lolobernardi/eeg-headset-project/README.md

# eeg-headset-project
Proyecto para el desarrollo de un casco EEG inalámbrico y portátil
