lolobernardi/eeg-headset-project/hardware/Casco_EEG_Kicad/3D_models/USB4125-GF-A_REVA2.step

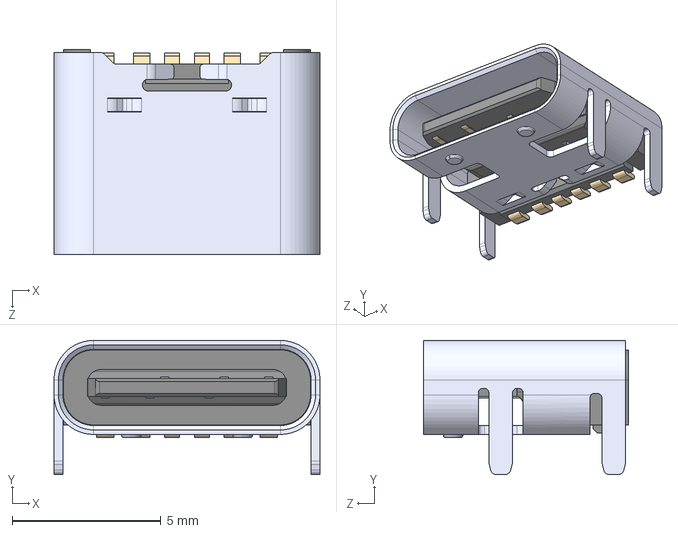
[picture p1: CAD file, 2025-10-28]
hardware/Casco_EEG_Kicad/3D_models/USB4125-GF-A_REVA2.step
8.94 x 4.51 x 6.90 mm
