lolobernardi/eeg-headset-project/hardware/Casco_EEG_Kicad/3D_models/PCM12SMTR.step

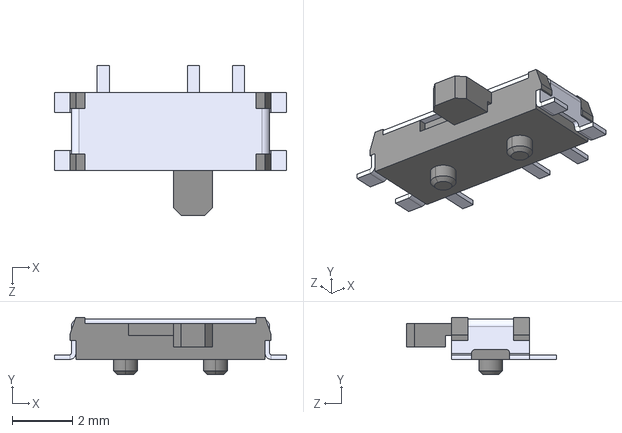
[picture p2: CAD file, 2025-10-28]
hardware/Casco_EEG_Kicad/3D_models/PCM12SMTR.step
7.72 x 1.91 x 4.98 mm
