lolobernardi/eeg-headset-project/hardware/Casco_EEG_Kicad/3D_models/AP2112K-3.3TRG1.step

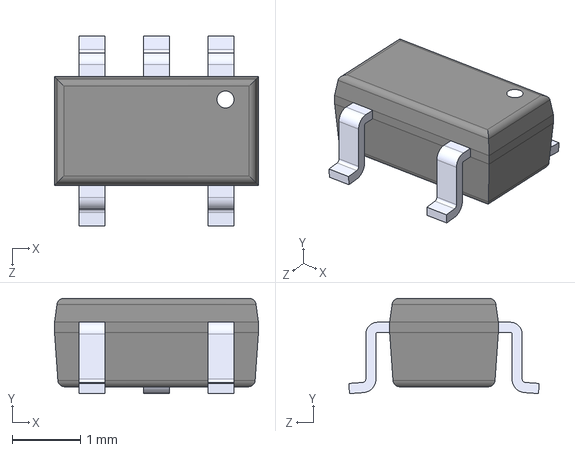
[picture p3: CAD file, 2025-10-09]
hardware/Casco_EEG_Kicad/3D_models/AP2112K-3.3TRG1.step
3.00 x 1.40 x 2.80 mm
