lolobernardi/eeg-headset-project/hardware/Casco_EEG_Kicad/3D_models/ADS1299IPAGR.STEP

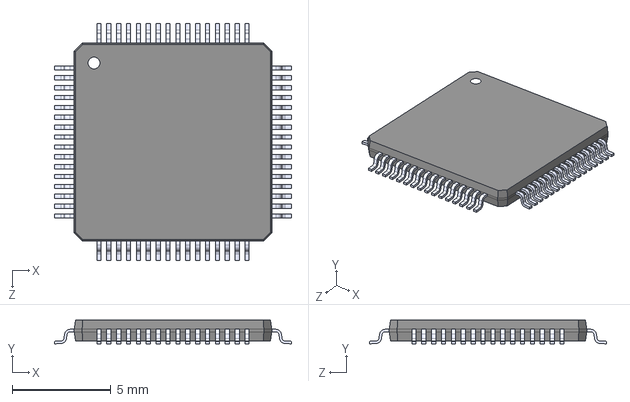
[picture p4: CAD file, 2025-10-09]
hardware/Casco_EEG_Kicad/3D_models/ADS1299IPAGR.STEP
12.0 x 1.20 x 12.0 mm
