lolobernardi/eeg-headset-project/hardware/Casco_EEG_Kicad/3D_models/TL3305AF160QG--3DModel-STEP-520916.STEP

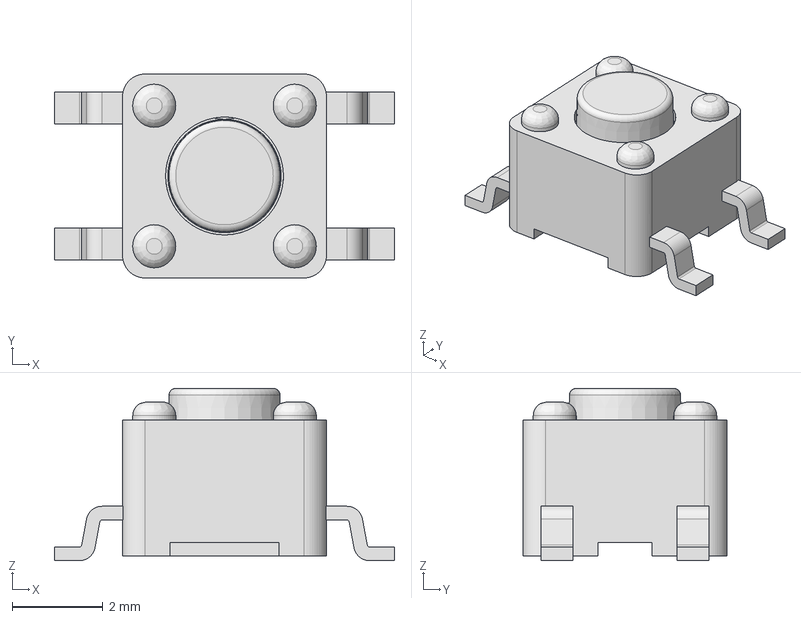
[picture p5: CAD file, 2025-10-09]
hardware/Casco_EEG_Kicad/3D_models/TL3305AF160QG--3DModel-STEP-520916.STEP
7.50 x 4.50 x 3.80 mm
