lolobernardi/eeg-headset-project/hardware/Casco_EEG_Kicad/3D_models/HZ0805E601R-10--3DModel-STEP-510211.STEP

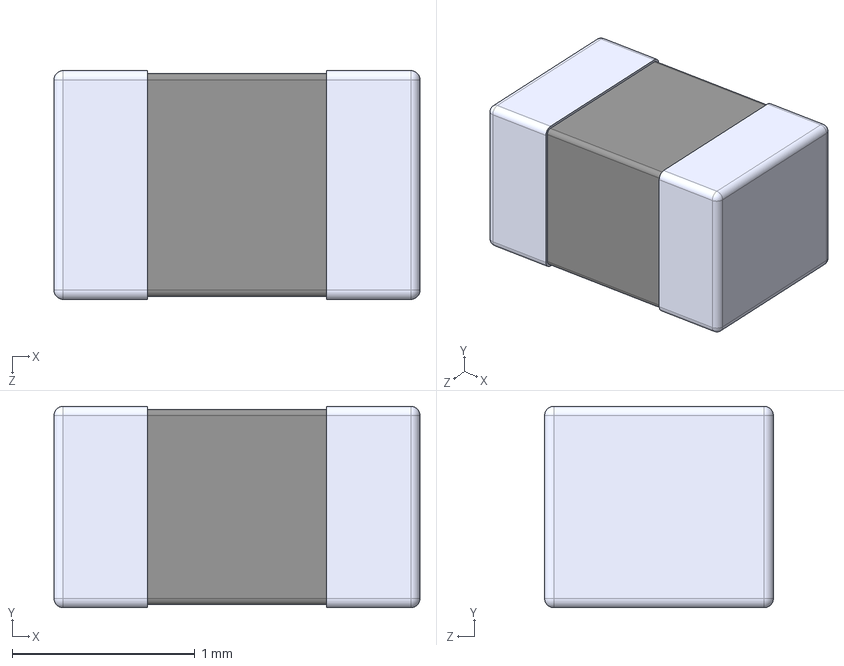
[picture p6: CAD file, 2025-10-09]
hardware/Casco_EEG_Kicad/3D_models/HZ0805E601R-10--3DModel-STEP-510211.STEP
2.00 x 1.10 x 1.25 mm
