lolobernardi/eeg-headset-project/hardware/Casco_EEG_Kicad/3D_models/USB3080-XX-00-A_REVE.step

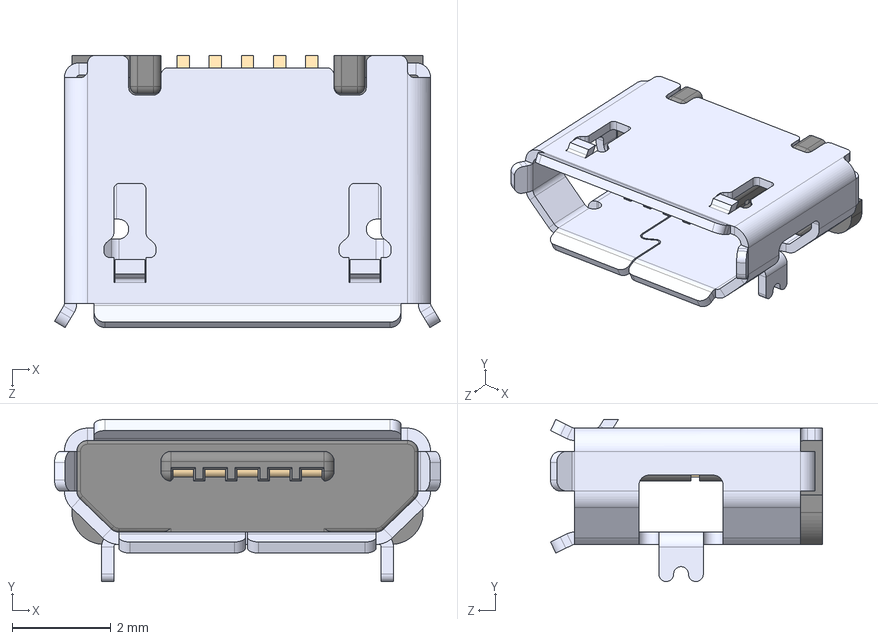
[picture p7: CAD file, 2025-10-09]
hardware/Casco_EEG_Kicad/3D_models/USB3080-XX-00-A_REVE.step
7.80 x 3.28 x 5.50 mm
