lolobernardi/eeg-headset-project/hardware/Casco_EEG_Kicad/3D_models/TP4056--3DModel-STEP-56544.STEP

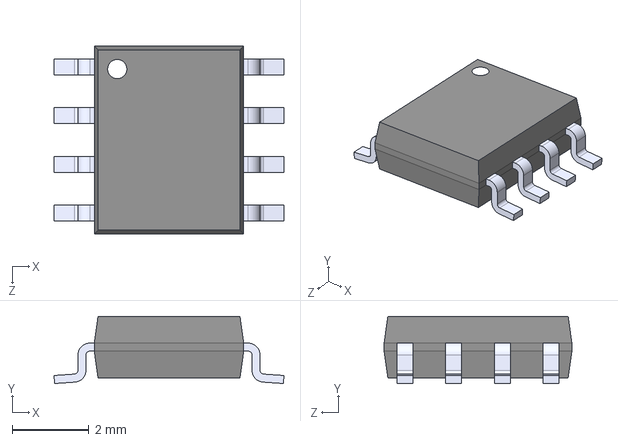
[picture p8: CAD file, 2025-10-09]
hardware/Casco_EEG_Kicad/3D_models/TP4056--3DModel-STEP-56544.STEP
6.00 x 1.75 x 4.90 mm
