lolobernardi/eeg-headset-project/hardware/Casco_EEG_Kicad/3D_models/SKRPABE010.step

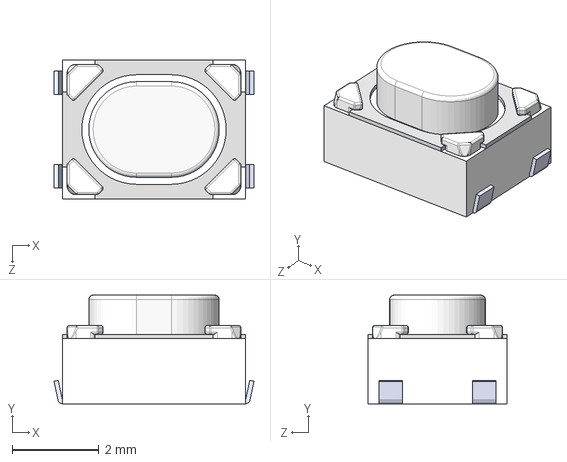
[picture p9: CAD file, 2025-10-02]
hardware/Casco_EEG_Kicad/3D_models/SKRPABE010.step
4.60 x 2.50 x 3.20 mm
