lolobernardi/eeg-headset-project/hardware/Casco_EEG_Kicad/3D_models/ME2108A33P.step

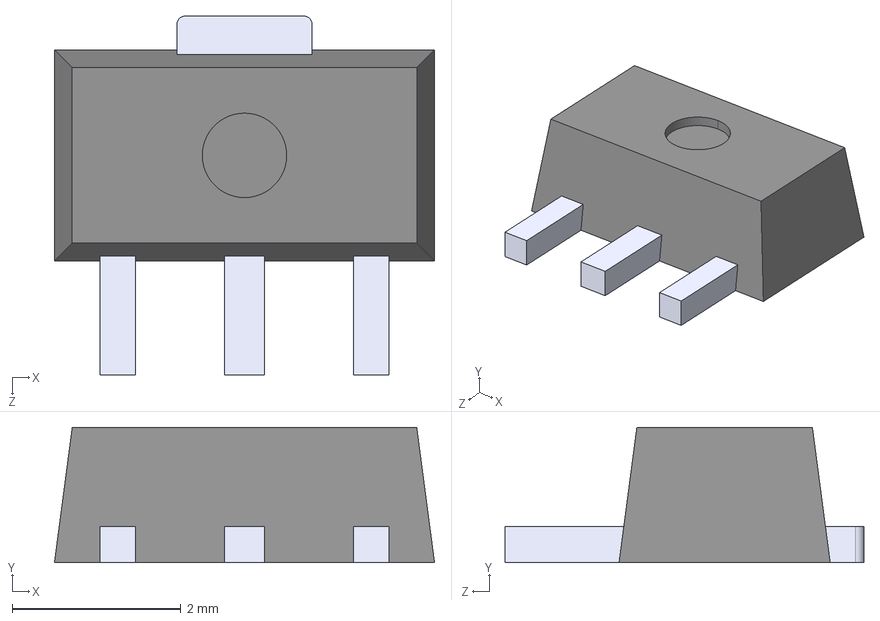
[picture p10: CAD file, 2025-10-02]
hardware/Casco_EEG_Kicad/3D_models/ME2108A33P.step
4.50 x 1.60 x 4.25 mm
