lolobernardi/eeg-headset-project/hardware/Casco_EEG_Kicad/3D_models/LPC845M301JBD64E.STEP

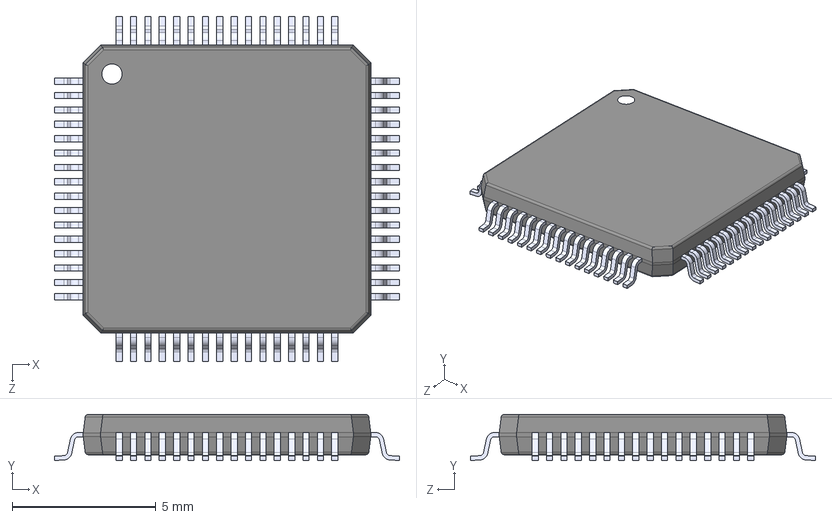
[picture p11: CAD file, 2025-10-02]
hardware/Casco_EEG_Kicad/3D_models/LPC845M301JBD64E.STEP
12.0 x 1.60 x 12.0 mm
