lolobernardi/eeg-headset-project/hardware/Casco_EEG_Kicad/3D_models/FS8205A.step

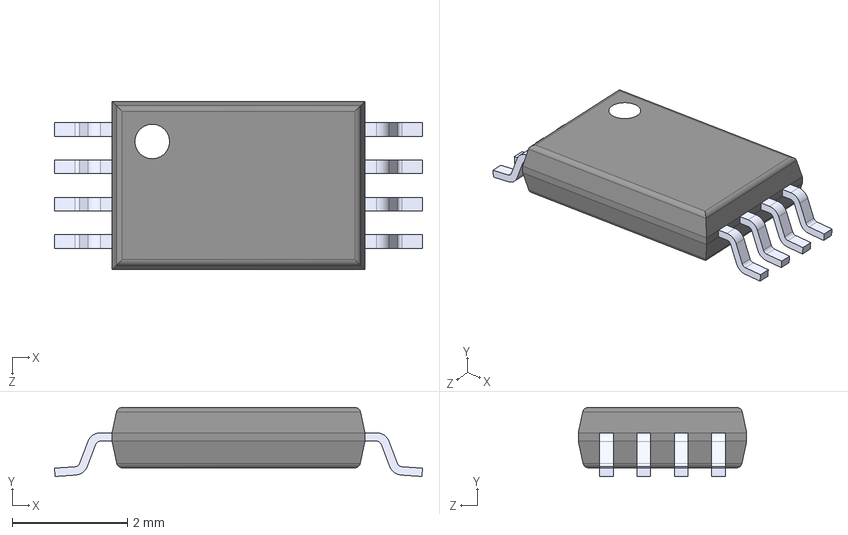
[picture p12: CAD file, 2025-10-02]
hardware/Casco_EEG_Kicad/3D_models/FS8205A.step
6.40 x 1.20 x 2.93 mm
