lolobernardi/eeg-headset-project/hardware/Casco_EEG_Kicad/3D_models/HC-05--3DModel-STEP-56544.STEP

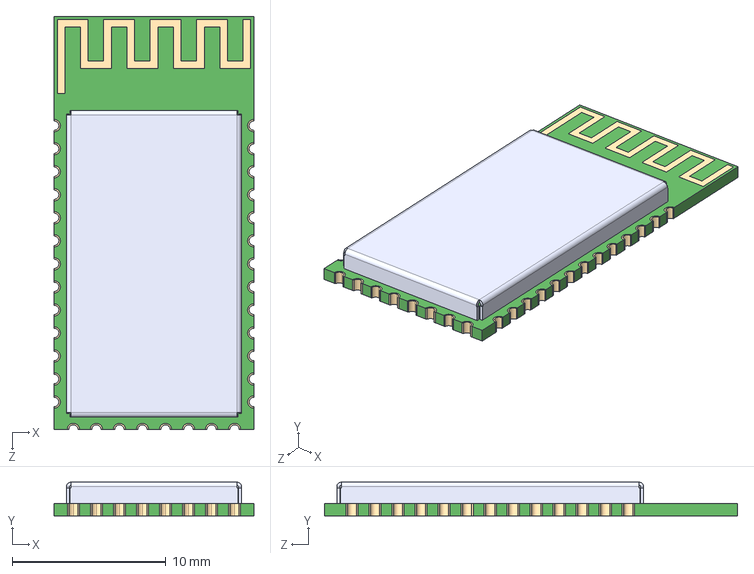
[picture p13: CAD file, 2025-10-02]
hardware/Casco_EEG_Kicad/3D_models/HC-05--3DModel-STEP-56544.STEP
13.0 x 2.20 x 26.9 mm
