lolobernardi/eeg-headset-project/hardware/Casco_EEG_Kicad/3D_models/FTSH-105-XX-X-DV.step

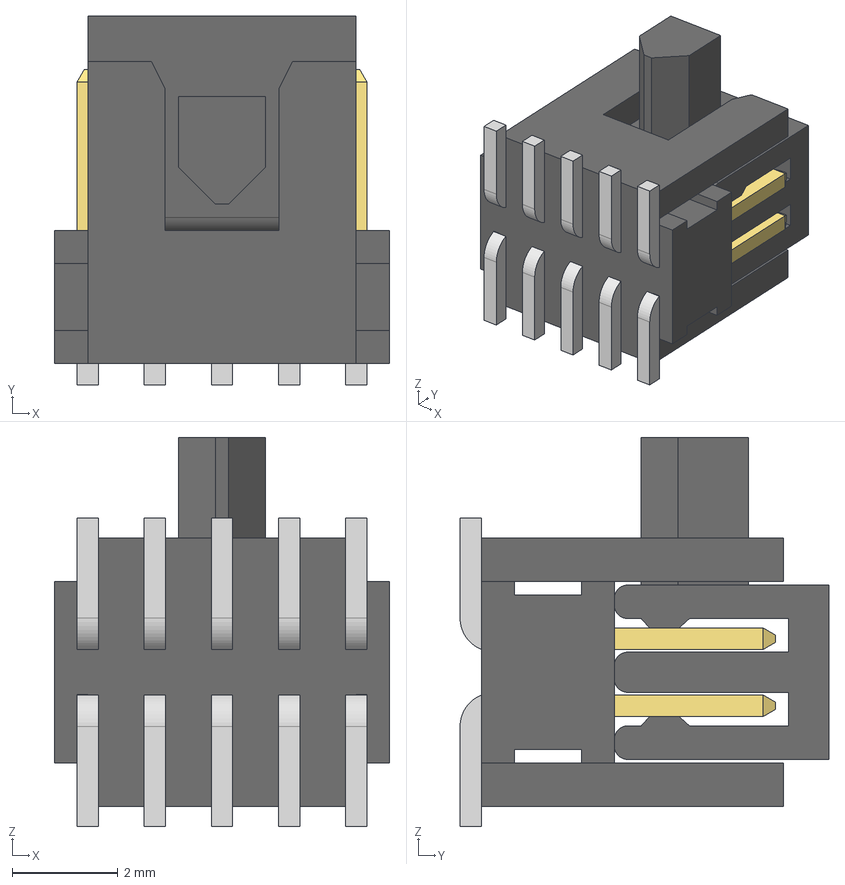
[picture p14: CAD file, 2025-10-02]
hardware/Casco_EEG_Kicad/3D_models/FTSH-105-XX-X-DV.step
6.35 x 6.98 x 7.37 mm
FTSH-105-01-L-DV-K-P_body
FTSH-105-01-L-DV-K-P_pins1
FTSH-105-01-L-DV-K-P_pins2
FTSH-105-01-L-DV-K-P_pp_pad
