lolobernardi/eeg-headset-project/hardware/Casco_EEG_Kicad/3D_models/Jack_TouchProof_1.5mm.STEP

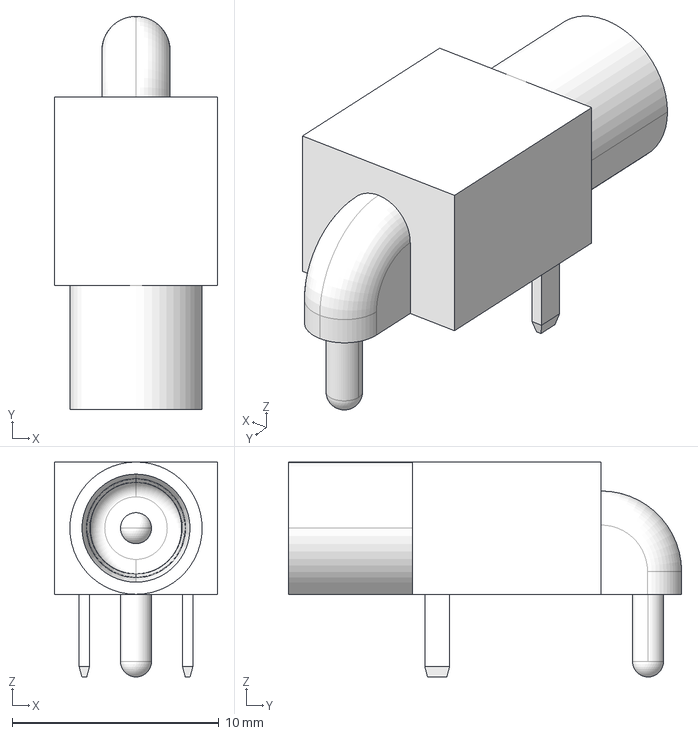
[picture p15: CAD file, 2025-10-02]
hardware/Casco_EEG_Kicad/3D_models/Jack_TouchProof_1.5mm.STEP
7.90 x 19.0 x 10.4 mm
