lolobernardi/eeg-headset-project/hardware/Casco_EEG_Kicad/3D_models/QFP50P900X900X160-48N.step

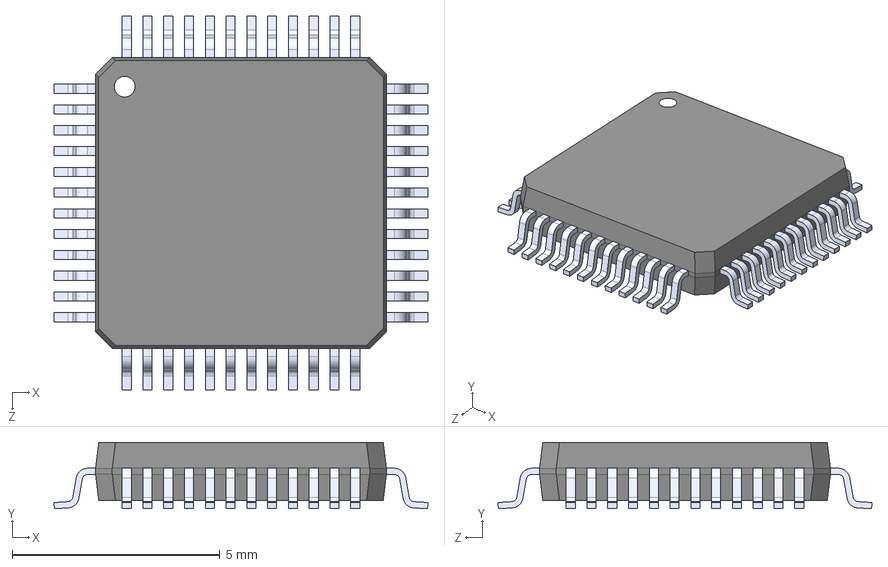
[picture p16: CAD file, 2025-09-03]
hardware/Casco_EEG_Kicad/3D_models/QFP50P900X900X160-48N.step
9.00 x 1.60 x 9.00 mm
