lolobernardi/eeg-headset-project/hardware/Casco_EEG_Kicad/PDFs/Casco_EEG_Kicad.pdf

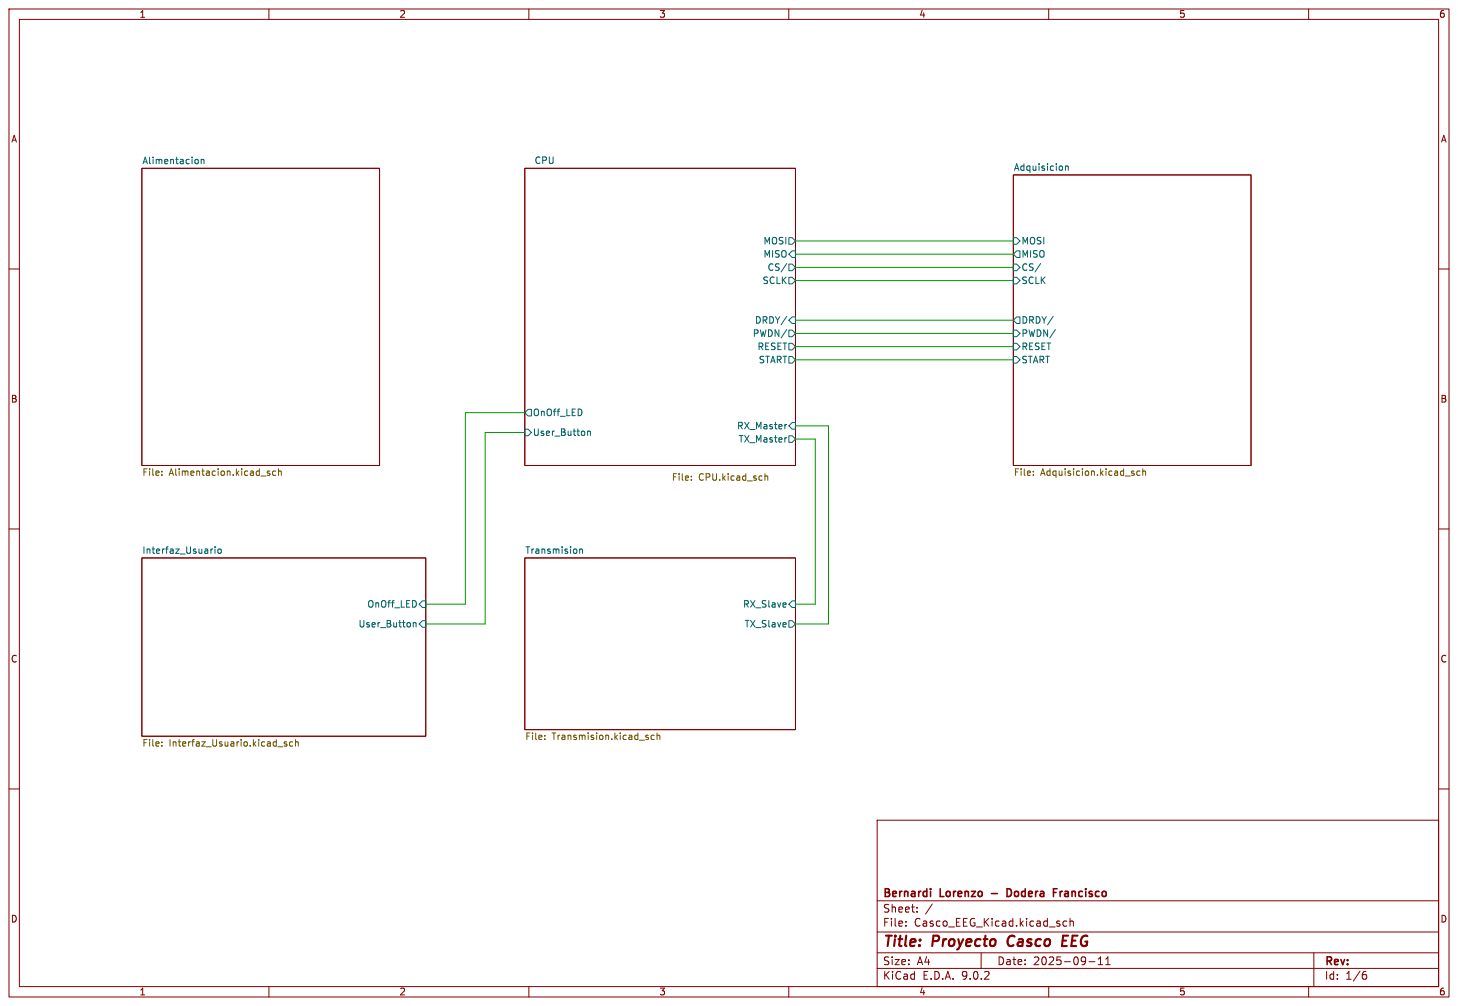
[picture p17: page 1]

START Adquisicion File: Adquisicion.kicad_sch RX_Master CS/ DRDY/ MISO MOSI PWDN/ RESET SCLK

CS/ DRDY/ MISO MOSI PWDN/ RESET SCLK

File: CPU.kicad_sch RX_Slave TX_Slave Transmision File: Transmision.kicad_sch

Id: 1/6 Title: Proyecto Casco EEG

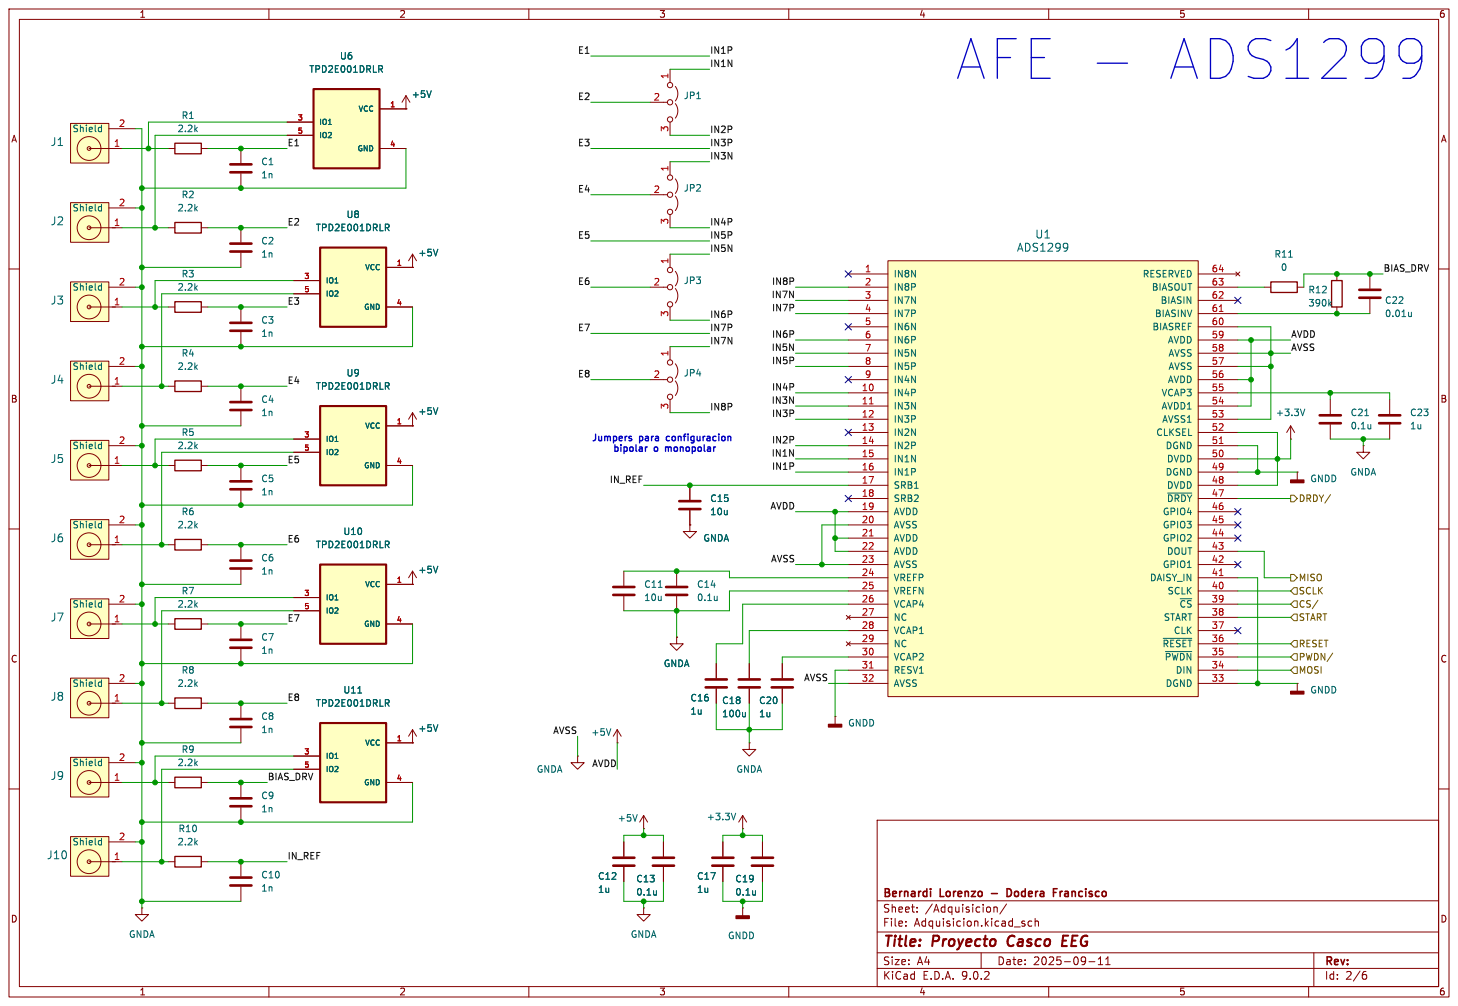
[picture p18: page 2]

START RESET MOSI PWDN/ DRDY/ SCLK MISO

Id: 2/6 Title: Proyecto Casco EEG

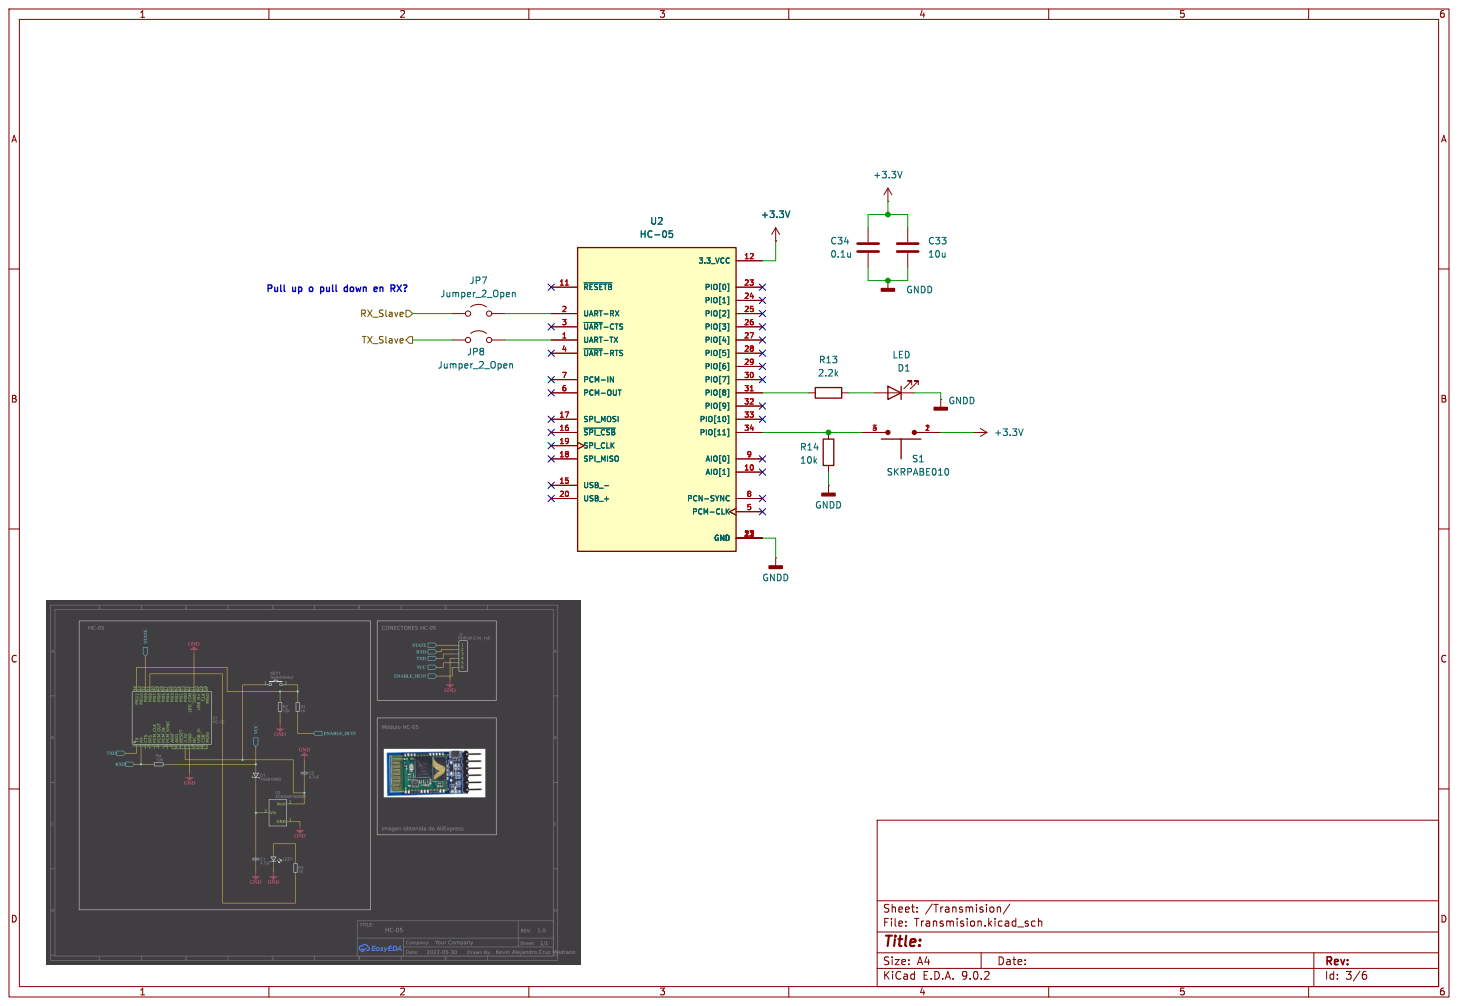
[picture p19: page 3]

TX_Slave RX_Slave Pull up o pull down en RX?

Id: 3/6 Title: File: Transmision.kicad_sch Sheet: /Transmision/

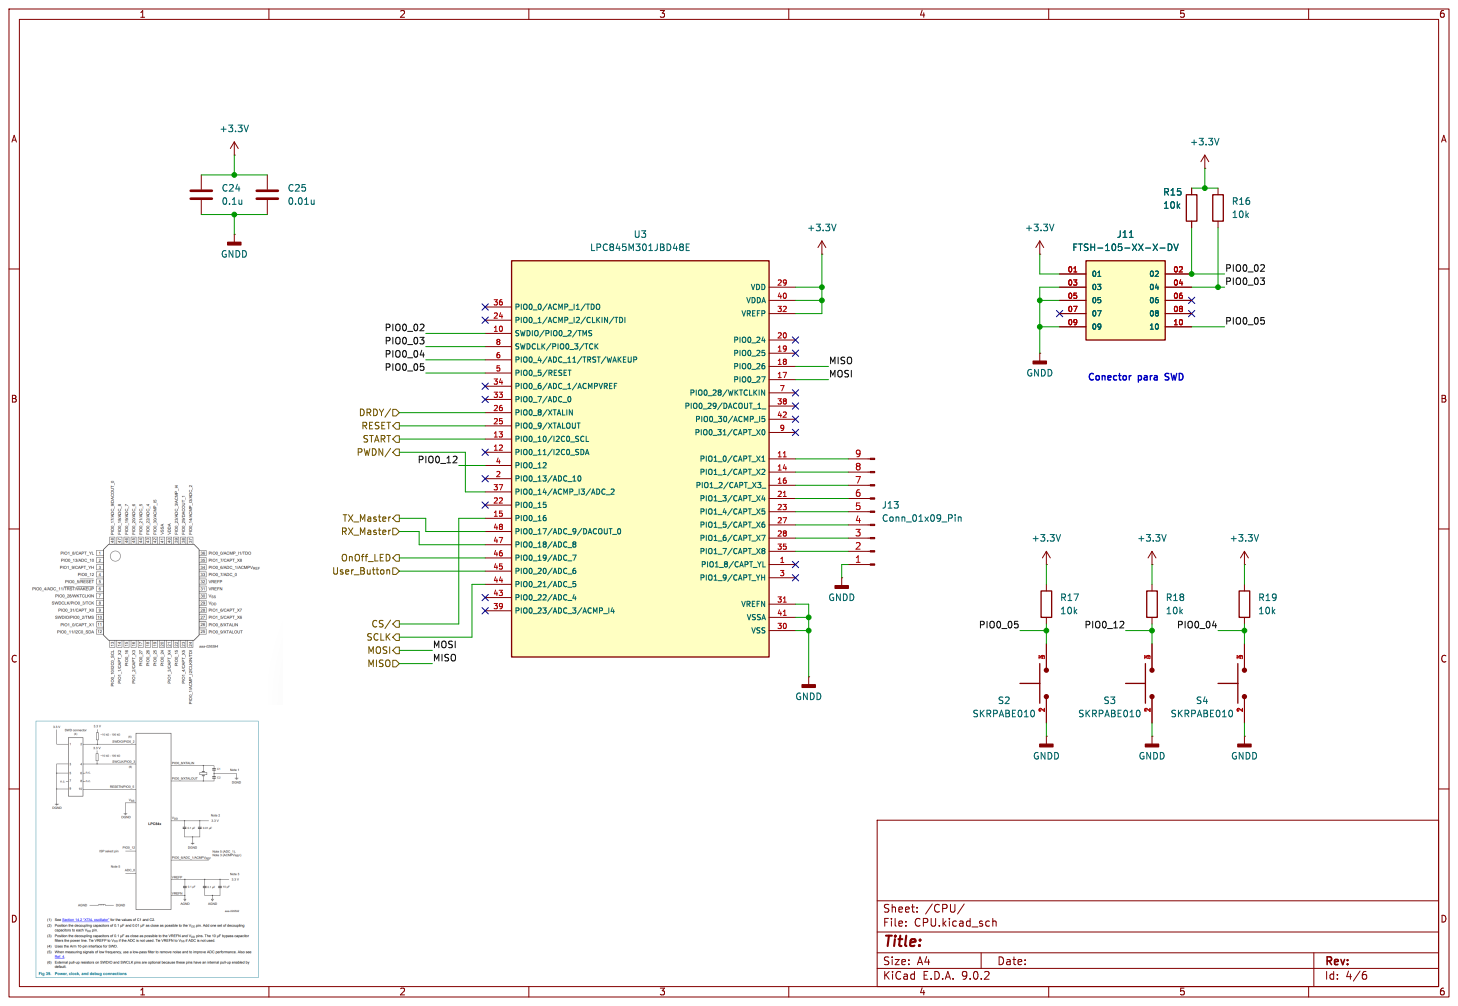
[picture p20: page 4]

RX_Master PWDN/ RESET START SCLK
CS/ TX_Master User_Button OnOff_LED

Id: 4/6 Title: File: CPU.kicad_sch Sheet: /CPU/

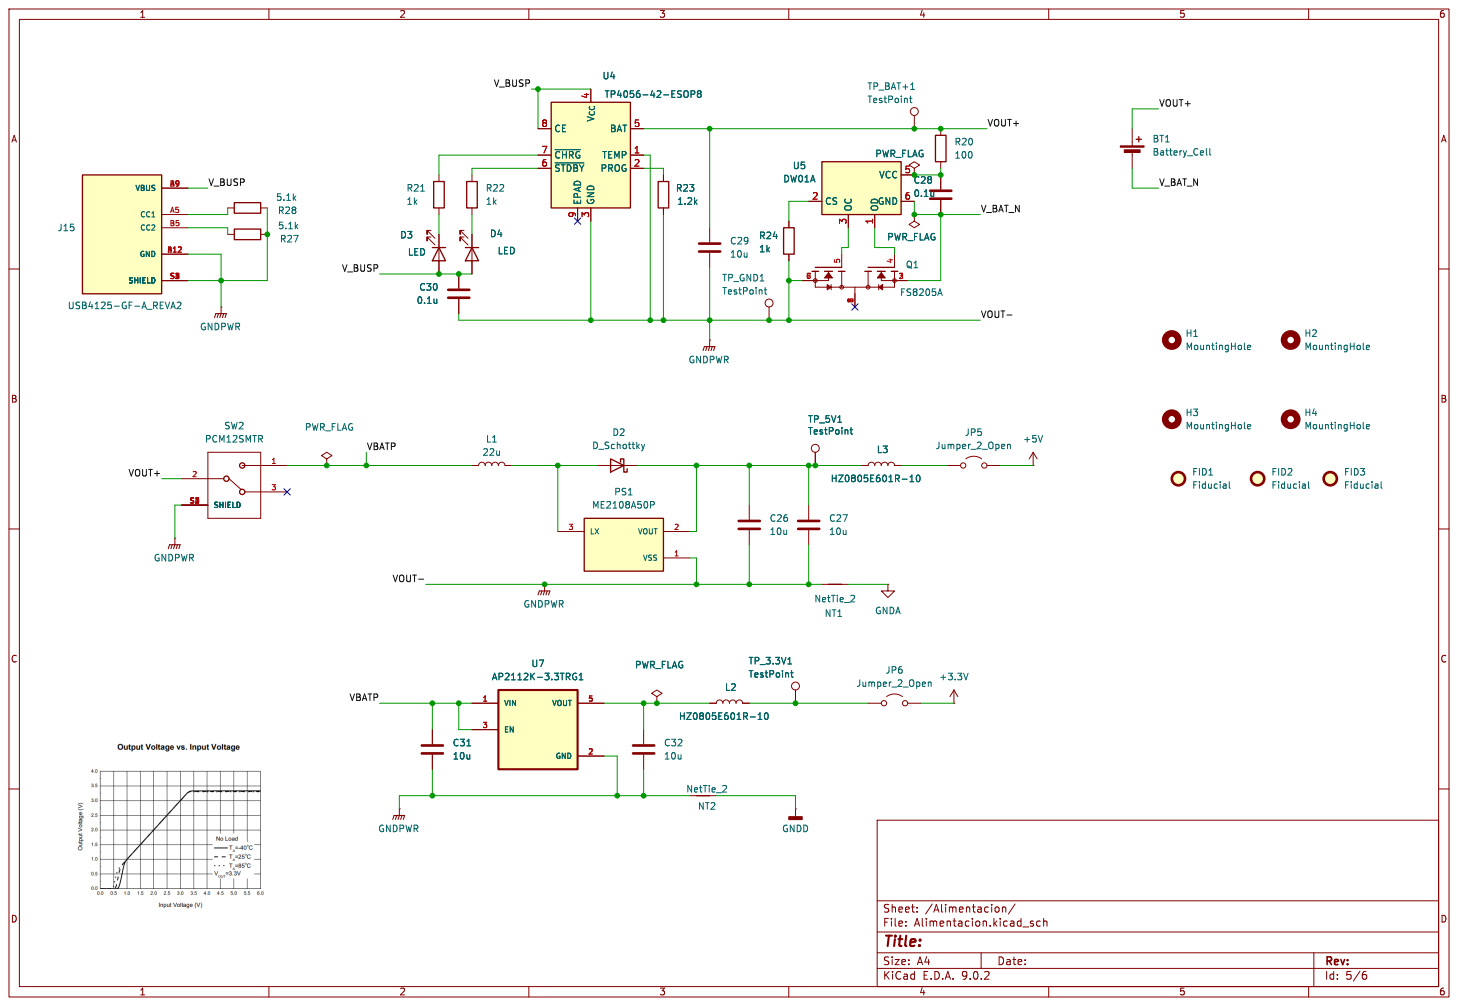
[picture p21: page 5]

Id: 5/6 Title: File: Alimentacion.kicad_sch Sheet: /Alimentacion/

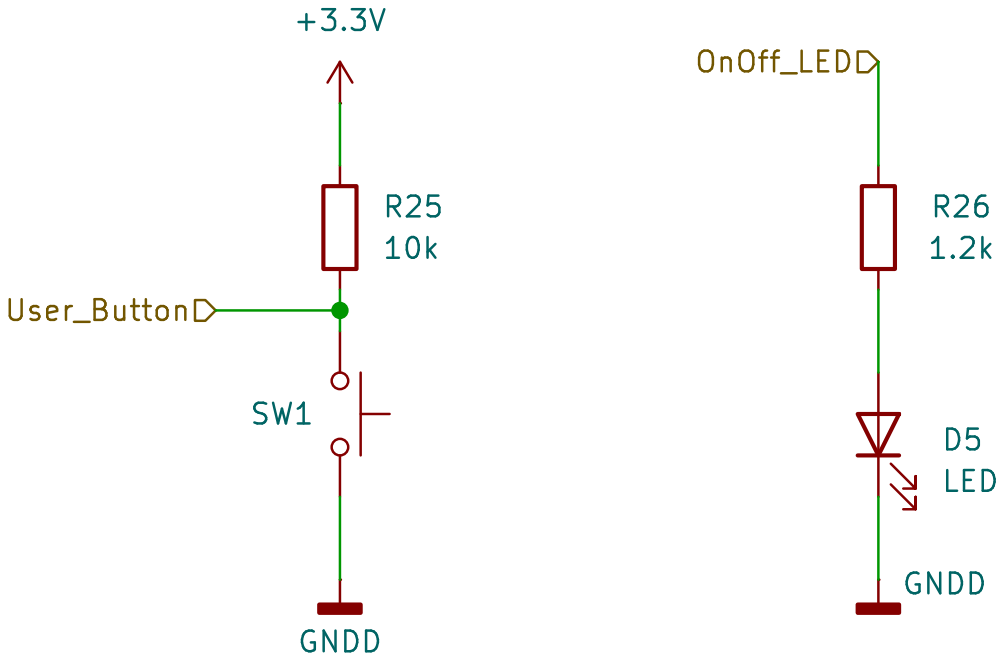
[picture p22: page 6]

Id: 6/6 Title: File: Interfaz_Usuario.kicad_sch Sheet: /Interfaz_Usuario/ GNDD
