lolobernardi/eeg-headset-project/hardware/Casco_EEG_Kicad/Casco_EEG_Kicad.kicad_pcb

## KiCad design hardware/Casco_EEG_Kicad/Casco_EEG_Kicad.kicad_pcb (2025-10-28)

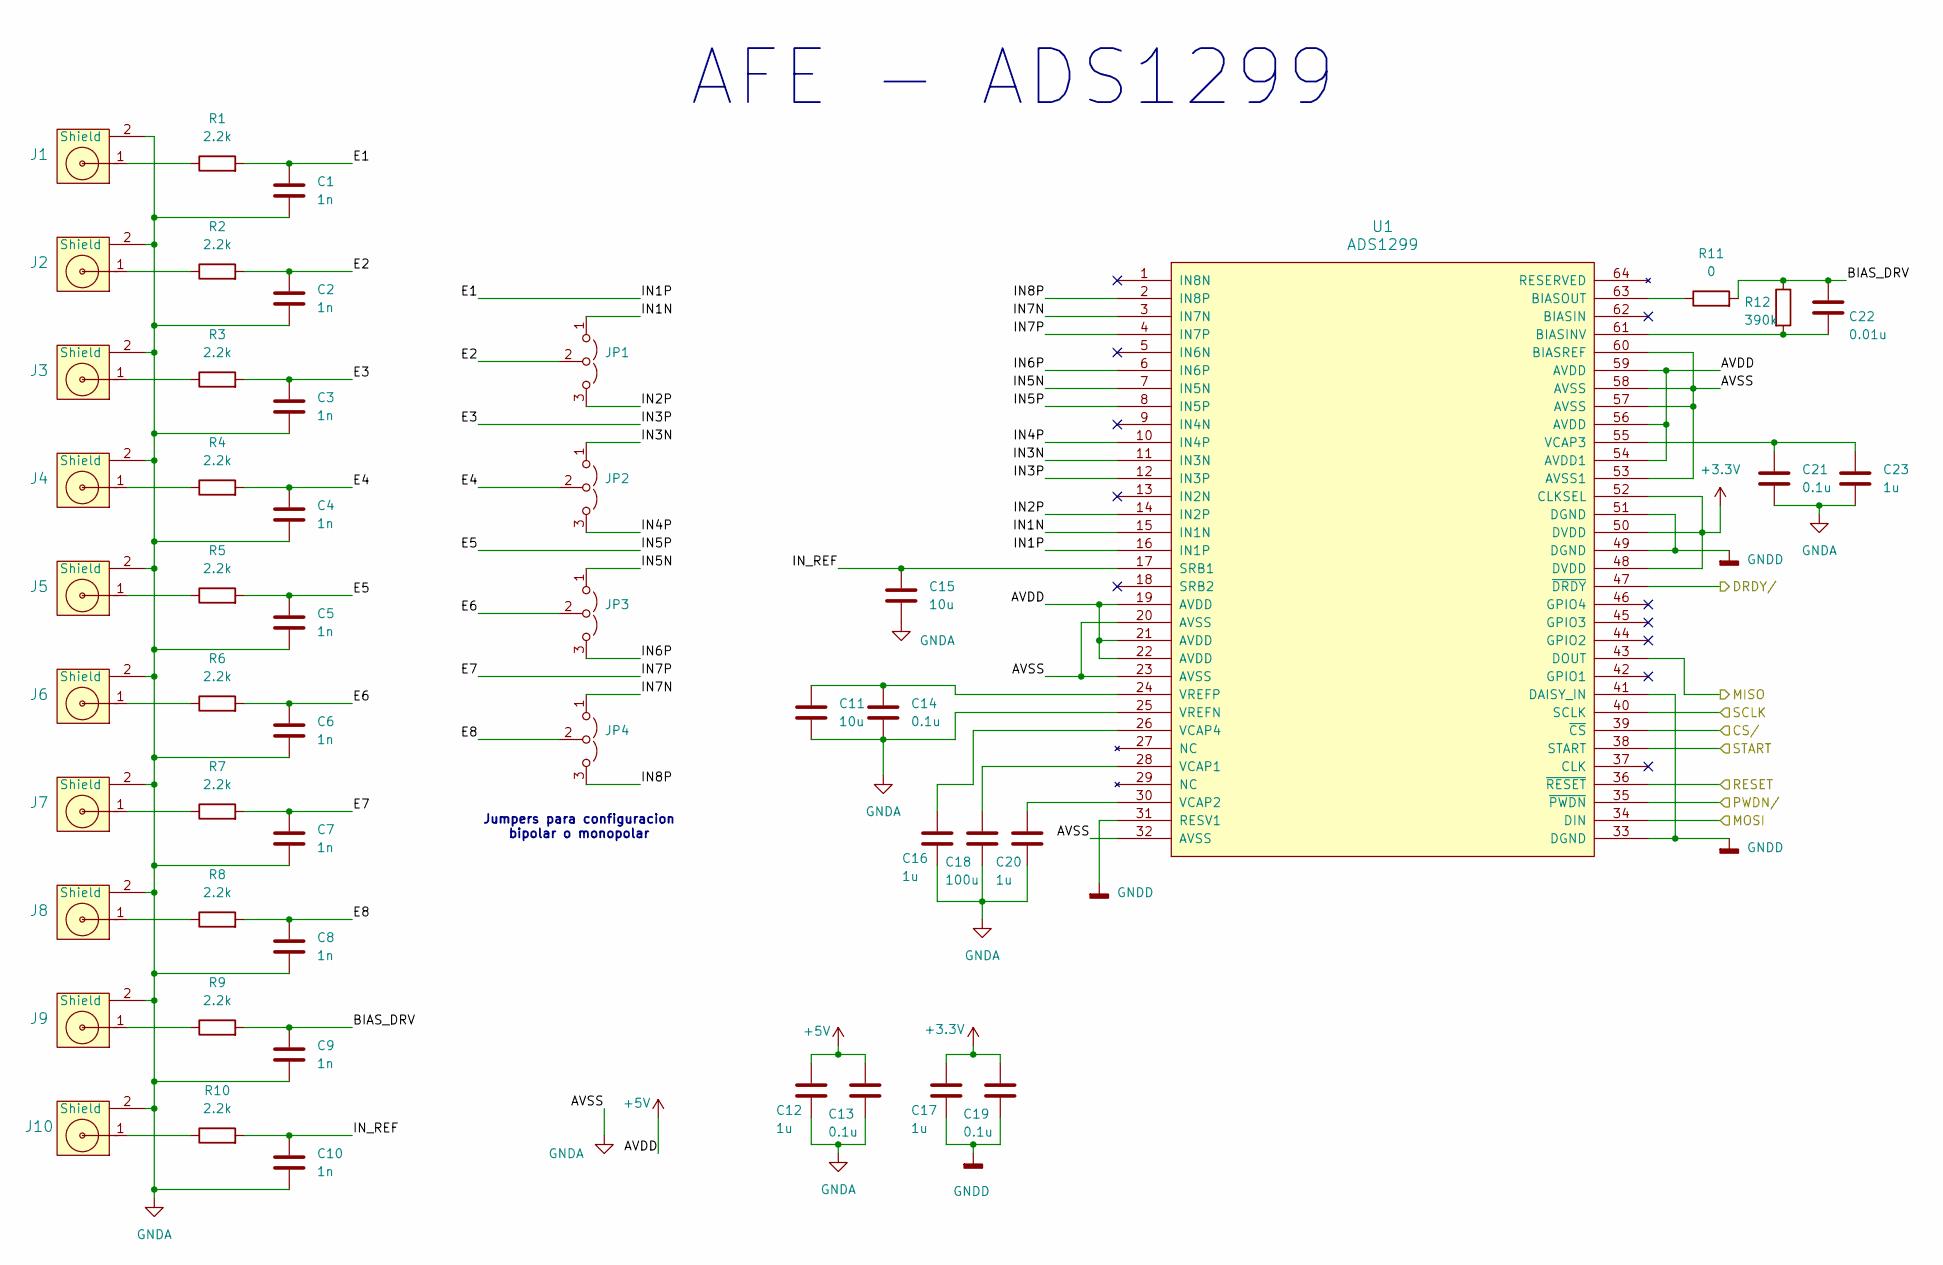
[picture p23: schematic Adquisicion.kicad_sch, Proyecto Casco EEG]

Parts:
C1, C2, C3, C4, C5, C6, C7, C8, C9, C10: 1n; C_0603_1608Metric; LCSC PN C1588
C11, C15: 10u; C_0603_1608Metric; LCSC PN C19702
C12, C16, C17, C20, C23: 1u; C_0603_1608Metric; LCSC PN C15849
C13, C14, C19, C21: 0.1u; C_0603_1608Metric; LCSC PN C14663
C18: 100u; C_0805_2012Metric; LCSC PN C141660
C22: 0.01u; C_0603_1608Metric; LCSC PN C57112
J1, J2, J3, J4, J5, J6, J7, J8, J9, J10: Jack_Touch-Proof; Jack_TouchProof_1.5mm
JP1, JP2, JP3, JP4: Jumper_3_Open; PinHeader_1x03_P2.54mm_Vertical
R1, R2, R3, R4, R5, R6, R7, R8, R9, R10: 2.2k; R_0603_1608Metric; LCSC PN C114662
R11: 0; R_0603_1608Metric
R12: 390k; R_0603_1608Metric; LCSC PN C23150
U1: ADS1299; PAG64_TEX; LCSC PN C476817

Connections:
+3.3V: C17.1, C19.1, U1.48 (DVDD), U1.50 (DVDD), U1.52 (CLKSEL); also elsewhere on the board
+5V: C12.1, C13.1, U1.19 (AVDD), U1.21 (AVDD), U1.22 (AVDD), U1.54 (AVDD1), U1.56 (AVDD), U1.59 (AVDD); also elsewhere on the board
/Adquisicion/BIAS_DRV: C9.1, C22.1, R9.2, R11.2, R12.1
/Adquisicion/CS/: U1.39 (~CS); also elsewhere on the board
/Adquisicion/DRDY/: U1.47 (~DRDY); also elsewhere on the board
/Adquisicion/E1: C1.1, R1.2, U1.16 (IN1P)
/Adquisicion/E2: C2.1, JP1.2 (C), R2.2
/Adquisicion/E3: C3.1, R3.2, U1.12 (IN3P)
/Adquisicion/E4: C4.1, JP2.2 (C), R4.2
/Adquisicion/E5: C5.1, R5.2, U1.8 (IN5P)
/Adquisicion/E6: C6.1, JP3.2 (C), R6.2
/Adquisicion/E7: C7.1, R7.2, U1.4 (IN7P)
/Adquisicion/E8: C8.1, JP4.2 (C), R8.2
/Adquisicion/IN1N: JP1.1 (A), U1.15 (IN1N)
/Adquisicion/IN2P: JP1.3 (B), U1.14 (IN2P)
/Adquisicion/IN3N: JP2.1 (A), U1.11 (IN3N)
/Adquisicion/IN4P: JP2.3 (B), U1.10 (IN4P)
/Adquisicion/IN5N: JP3.1 (A), U1.7 (IN5N)
/Adquisicion/IN6P: JP3.3 (B), U1.6 (IN6P)
/Adquisicion/IN7N: JP4.1 (A), U1.3 (IN7N)
/Adquisicion/IN8P: JP4.3 (B), U1.2 (IN8P)
/Adquisicion/IN_REF: C10.1, C15.1, R10.2, U1.17 (SRB1)
/Adquisicion/PWDN/: U1.35 (~PWDN); also elsewhere on the board
/Adquisicion/RESET: U1.36 (~RESET); also elsewhere on the board
/Adquisicion/SCLK: U1.40 (SCLK); also elsewhere on the board
/Adquisicion/START: U1.38 (START); also elsewhere on the board
/CPU/MISO: U1.43 (DOUT); also elsewhere on the board
/CPU/MOSI: U1.34 (DIN); also elsewhere on the board
GNDA: C1.2, C2.2, C3.2, C4.2, C5.2, C6.2, C7.2, C8.2, C9.2, C10.2, C11.2, C12.2, C13.2, C14.2, C15.2, C16.2, C18.2, C20.2, C21.2, C23.2, J1.2 (Shield), J2.2 (Shield), J3.2 (Shield), J4.2 (Shield), J5.2 (Shield), J6.2 (Shield), J7.2 (Shield), J8.2 (Shield), J9.2 (Shield), J10.2 (Shield), U1.20 (AVSS), U1.23 (AVSS), U1.25 (VREFN), U1.32 (AVSS), U1.53 (AVSS1), U1.57 (AVSS), U1.58 (AVSS), U1.60 (BIASREF); also elsewhere on the board
GNDD: C17.2, C19.2, U1.31 (RESV1), U1.33 (DGND), U1.41 (DAISY_IN), U1.49 (DGND), U1.51 (DGND); also elsewhere on the board
unnamed: J1.1, R1.1
unnamed: J2.1, R2.1
unnamed: J3.1, R3.1
unnamed: J4.1, R4.1
unnamed: J5.1, R5.1
unnamed: J6.1, R6.1
unnamed: J7.1, R7.1
unnamed: J8.1, R8.1
unnamed: J9.1, R9.1
unnamed: J10.1, R10.1
unnamed: C22.2, R12.2, U1.61 (BIASINV)
unnamed: R11.1, U1.63 (BIASOUT)
unnamed: C18.1, U1.28 (VCAP1)
unnamed: C20.1, U1.30 (VCAP2)
unnamed: C21.1, C23.1, U1.55 (VCAP3)
unnamed: C16.1, U1.26 (VCAP4)
unnamed: C11.1, C14.1, U1.24 (VREFP)

Notes on the sheet:
AFE - ADS1299
Jumpers para configuracion bipolar o monopolar

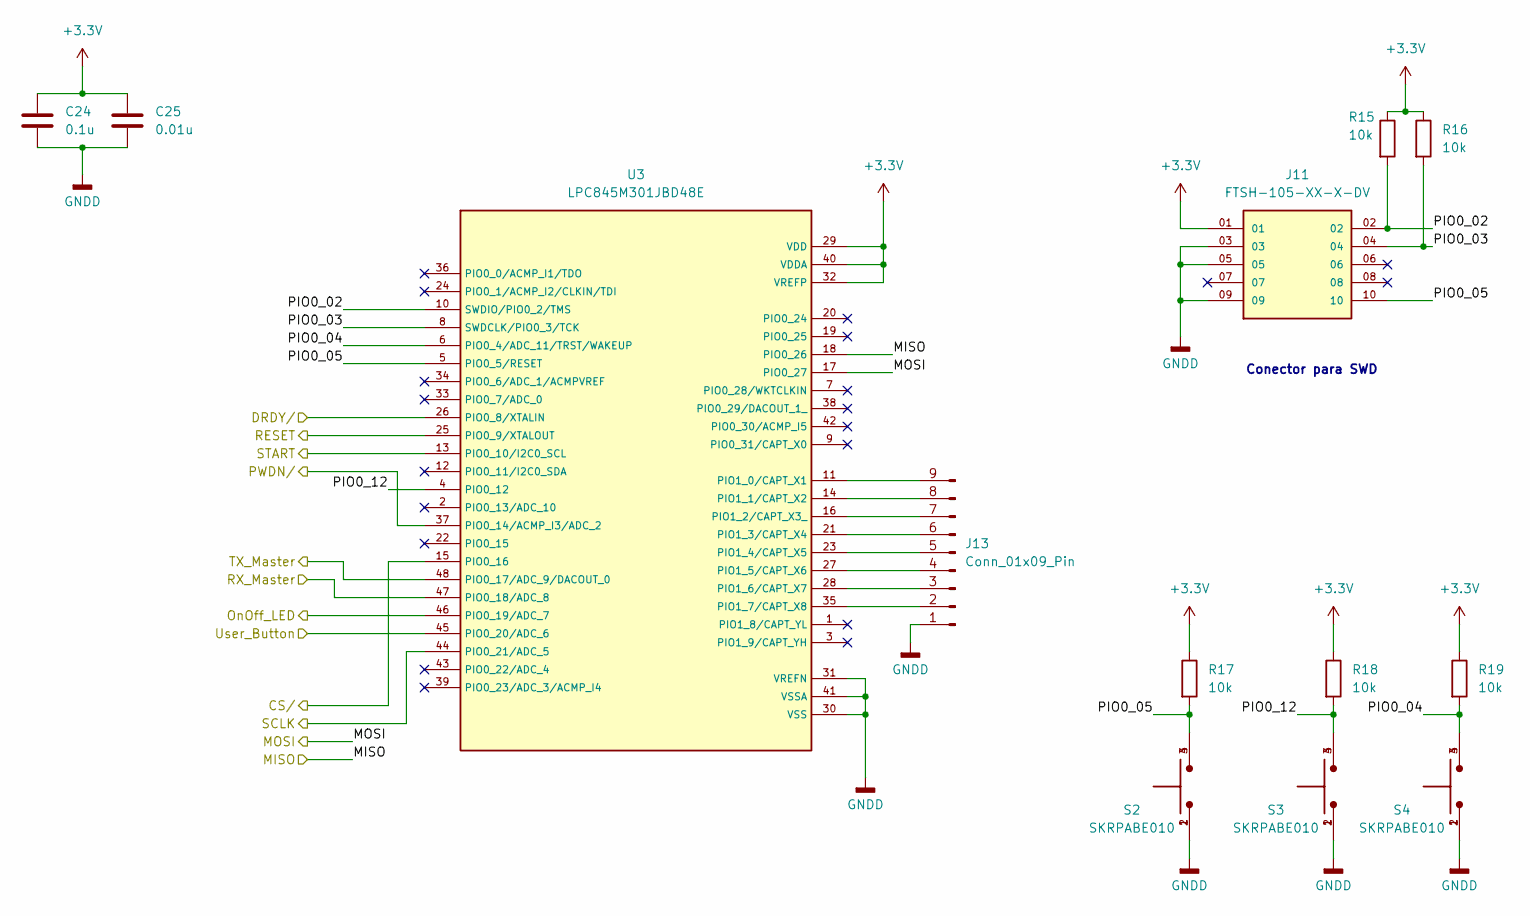
[picture p24: schematic CPU.kicad_sch]

Parts:
C24: 0.1u; C_0603_1608Metric; LCSC PN C14663
C25: 0.01u; C_0603_1608Metric; LCSC PN C57112
J11: FTSH-105-XX-X-DV; SAMTEC_FTSH-105-XX-X-DV; PARTREV H; LCSC PN C448647
J13: Conn_01x09_Pin; PinHeader_1x09_P2.54mm_Horizontal
R15, R16, R17, R18, R19: 10k; R_0603_1608Metric; LCSC PN C25804
S2, S3, S4: SKRPABE010; SW_SKRPABE010; LCSC PN C115360
U3: LPC845M301JBD48E; QFP50P900X900X160-48N; LCSC PN C178288

Connections:
+3.3V: C24.1, C25.1, J11.01, R15.1, R16.1, R17.1, R18.1, R19.1, U3.29 (VDD), U3.32 (VREFP), U3.40 (VDDA); also elsewhere on the board
/Adquisicion/CS/: U3.15 (PIO0_16); also elsewhere on the board
/Adquisicion/DRDY/: U3.26 (PIO0_8/XTALIN); also elsewhere on the board
/Adquisicion/PWDN/: U3.37 (PIO0_14/ACMP_I3/ADC_2); also elsewhere on the board
/Adquisicion/RESET: U3.25 (PIO0_9/XTALOUT); also elsewhere on the board
/Adquisicion/SCLK: U3.44 (PIO0_21/ADC_5); also elsewhere on the board
/Adquisicion/START: U3.13 (PIO0_10/I2C0_SCL); also elsewhere on the board
/CPU/MISO: U3.18 (PIO0_26); also elsewhere on the board
/CPU/MOSI: U3.17 (PIO0_27); also elsewhere on the board
/CPU/OnOff_LED: U3.46 (PIO0_19/ADC_7); also elsewhere on the board
/CPU/PIO0_02: J11.02, R15.2, U3.10 (SWDIO/PIO0_2/TMS)
/CPU/PIO0_03: J11.04, R16.2, U3.8 (SWDCLK/PIO0_3/TCK)
/CPU/PIO0_04: R19.2, S4.3, S4.4, U3.6 (PIO0_4/ADC_11/TRST/WAKEUP)
/CPU/PIO0_05: J11.10, R17.2, S2.3, S2.4, U3.5 (PIO0_5/RESET)
/CPU/PIO0_12: R18.2, S3.3, S3.4, U3.4 (PIO0_12)
/CPU/RX_Master: U3.47 (PIO0_18/ADC_8); also elsewhere on the board
/CPU/TX_Master: U3.48 (PIO0_17/ADC_9/DACOUT_0); also elsewhere on the board
/CPU/User_Button: U3.45 (PIO0_20/ADC_6); also elsewhere on the board
GNDD: C24.2, C25.2, J11.03, J11.05, J11.09, J13.1, S2.1, S2.2, S3.1, S3.2, S4.1, S4.2, U3.30 (VSS), U3.31 (VREFN), U3.41 (VSSA); also elsewhere on the board
unnamed: J13.2, U3.35 (PIO1_7/CAPT_X8)
unnamed: J13.3, U3.28 (PIO1_6/CAPT_X7)
unnamed: J13.4, U3.27 (PIO1_5/CAPT_X6)
unnamed: J13.5, U3.23 (PIO1_4/CAPT_X5)
unnamed: J13.6, U3.21 (PIO1_3/CAPT_X4)
unnamed: J13.7, U3.16 (PIO1_2/CAPT_X3_)
unnamed: J13.8, U3.14 (PIO1_1/CAPT_X2)
unnamed: J13.9, U3.11 (PIO1_0/CAPT_X1)

Notes on the sheet:
Conector para SWD

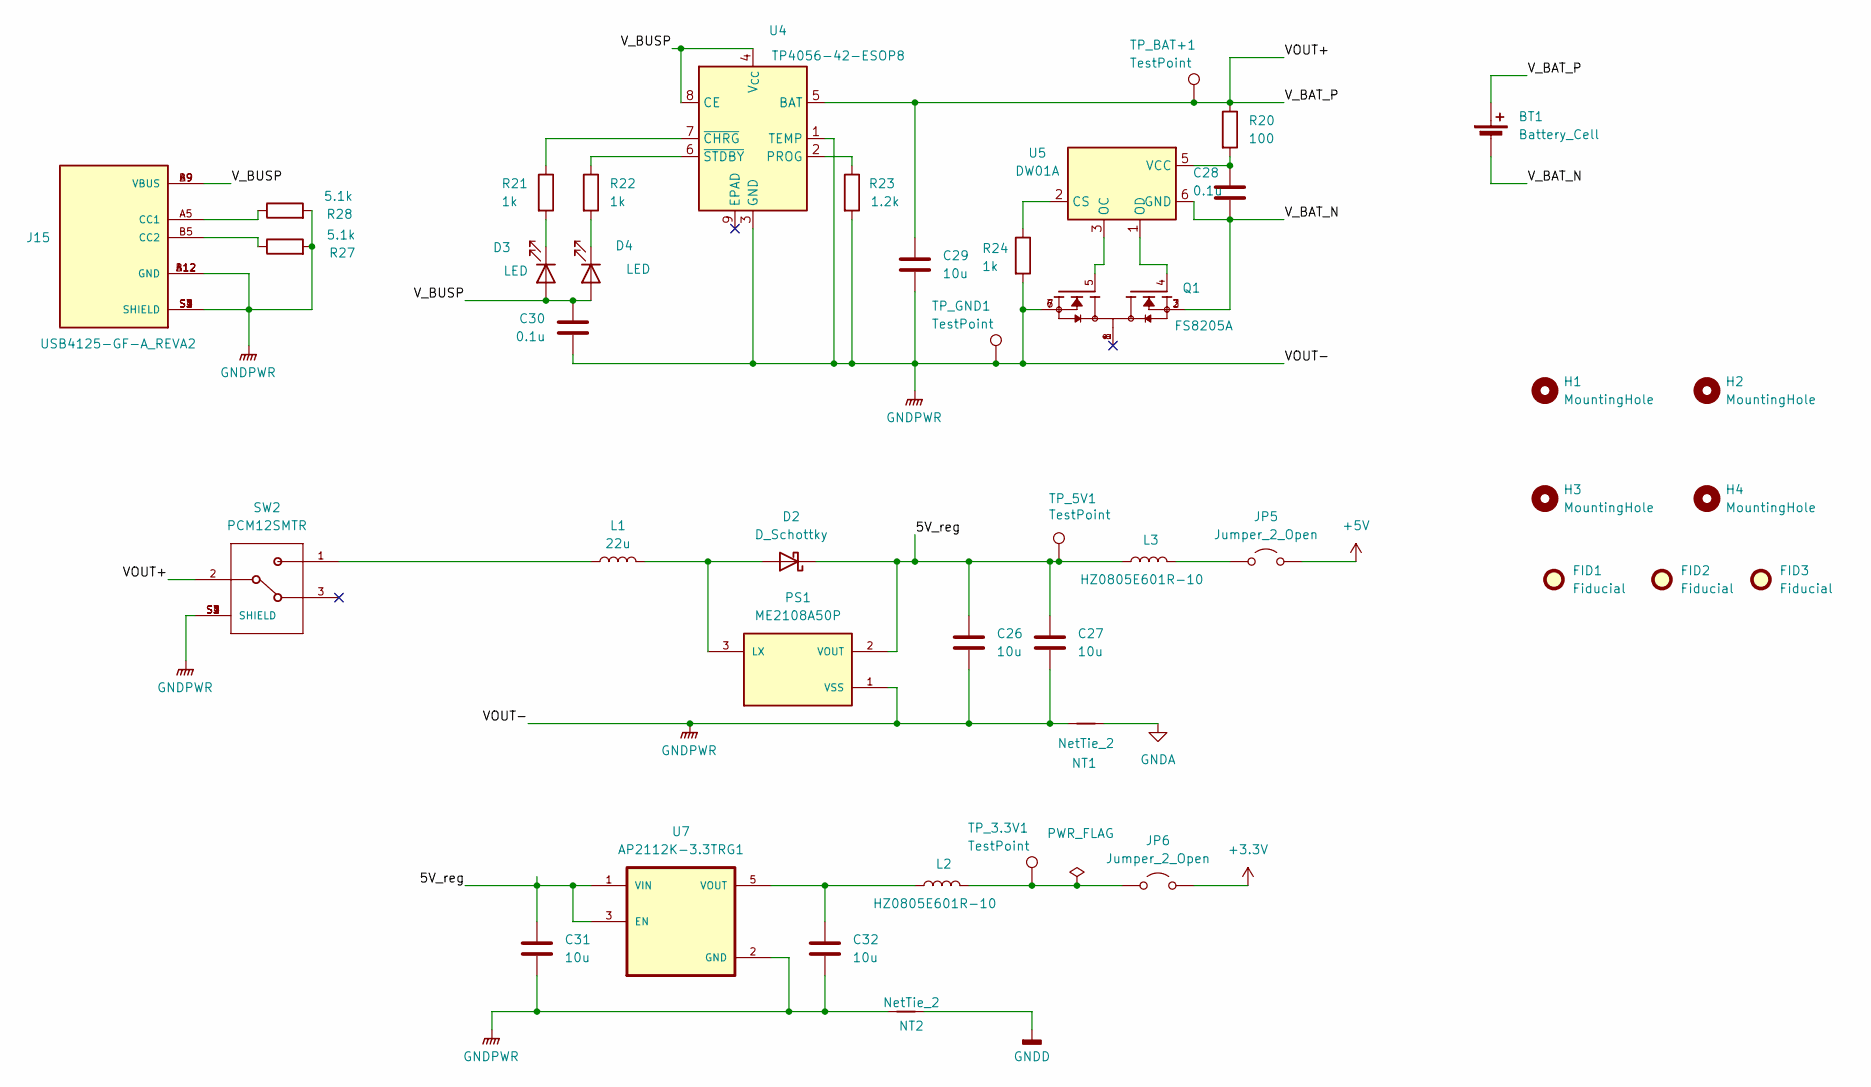
[picture p25: schematic Alimentacion.kicad_sch]

Parts:
BT1: Battery_Cell; BatteryHolder_Keystone_1042_1x18650
C26, C27: 10u; C_0805_2012Metric; LCSC PN C19702
C28, C30: 0.1u; C_0603_1608Metric; LCSC PN C14663
C29, C31, C32: 10u; C_0603_1608Metric; LCSC PN C19702
D2: D_Schottky; D_SMA; LCSC PN C2480
D3, D4: LED; LED_0603_1608Metric
FID1, FID2, FID3: Fiducial; Fiducial_0.5mm_Mask1mm
H1, H2, H3, H4: MountingHole; MountingHole_2.2mm_M2_Pad_Via
J15: USB4125-GF-A_REVA2; GCT_USB4125-GF-A_REVA2; PARTREV Rev A2
JP5, JP6: Jumper_2_Open; PinHeader_1x02_P2.54mm_Vertical
L1: 22u; L_Coilcraft_XAL5030-XXX
L2, L3: HZ0805E601R-10; L_Eaton_MCL2012V1; LCSC PN C2441364
NT1, NT2: NetTie_2; NetTie-2_SMD_Pad2.0mm
PS1: ME2108A50P; CONV_ME2108A33P; LCSC PN C236798
Q1: FS8205A; SOP65P640X120-8N; PARTREV 1.7; LCSC PN C2830320
R20: 100; R_0603_1608Metric; LCSC PN C22775
R21, R22, R24: 1k; R_0603_1608Metric; LCSC PN C21190
R23: 1.2k; R_0603_1608Metric; LCSC PN C22765
R27, R28: 5.1k; R_0603_1608Metric; LCSC PN C21190
SW2: PCM12SMTR; SW_PCM12SMTR
TP_3.3V1, TP_5V1: TestPoint; TestPoint_Pad_D2.0mm
TP_BAT+1: TestPoint; TestPoint_Pad_D2.0mm
TP_GND1: TestPoint; TestPoint_Pad_D2.0mm
U4: TP4056-42-ESOP8; SOIC-8-1EP_3.9x4.9mm_P1.27mm_EP2.41x3.3mm_ThermalVias; LCSC PN C16581
U5: DW01A; SOT-23-6; LCSC PN C2927799
U7: AP2112K-3.3TRG1; SOT95P285X140-5N; PARTREV 2-2; LCSC PN C51118

Connections:
+3.3V: JP6.2 (B); also elsewhere on the board
+5V: JP5.2 (B); also elsewhere on the board
/Alimentacion/5V_reg: C26.1, C27.1, C31.1, D2.1 (K), L3.1, PS1.2 (VOUT), TP_5V1.1, U7.1 (VIN), U7.3 (EN)
/Alimentacion/VOUT+: BT1.1 (+), C29.1, R20.1, SW2.2, TP_BAT+1.1, U4.5 (BAT)
/Alimentacion/V_BAT_N: BT1.2 (-), C28.2, Q1.2, Q1.3, U5.6 (GND)
/Alimentacion/V_BUSP: C30.1, D3.2 (A), D4.2 (A), J15.A9 (VBUS), J15.B9 (VBUS), U4.4 (V_{CC}), U4.8 (CE)
GNDA: NT1.2; also elsewhere on the board
GNDD: NT2.2; also elsewhere on the board
GNDPWR: C26.2, C27.2, C29.2, C30.2, C31.2, C32.2, J15.A12 (GND), J15.B12 (GND), J15.S1 (SHIELD), J15.S2 (SHIELD), J15.S3 (SHIELD), J15.S4 (SHIELD), NT1.1, NT2.1, PS1.1 (VSS), Q1.6, Q1.7, R23.2, R24.2, R27.2, R28.2, SW2.S1 (SHIELD), SW2.S2 (SHIELD), SW2.S3 (SHIELD), SW2.S4 (SHIELD), TP_GND1.1, U4.1 (TEMP), U4.3 (GND), U7.2 (GND)
unnamed: D2.2 (A), L1.2, PS1.3 (LX)
unnamed: D3.1 (K), R21.2
unnamed: D4.1 (K), R22.2
unnamed: J15.A5 (CC1), R28.1
unnamed: J15.B5 (CC2), R27.1
unnamed: JP5.1 (A), L3.2
unnamed: JP6.1 (A), L2.2, TP_3.3V1.1
unnamed: L1.1, SW2.1
unnamed: R23.1, U4.2 (PROG)
unnamed: R21.1, U4.7 (~CHRG)
unnamed: R22.1, U4.6 (~STDBY)
unnamed: R24.1, U5.2 (CS)
unnamed: Q1.5, U5.3 (OC)
unnamed: Q1.4, U5.1 (OD)
unnamed: C28.1, R20.2, U5.5 (VCC)
unnamed: C32.1, L2.1, U7.5 (VOUT)

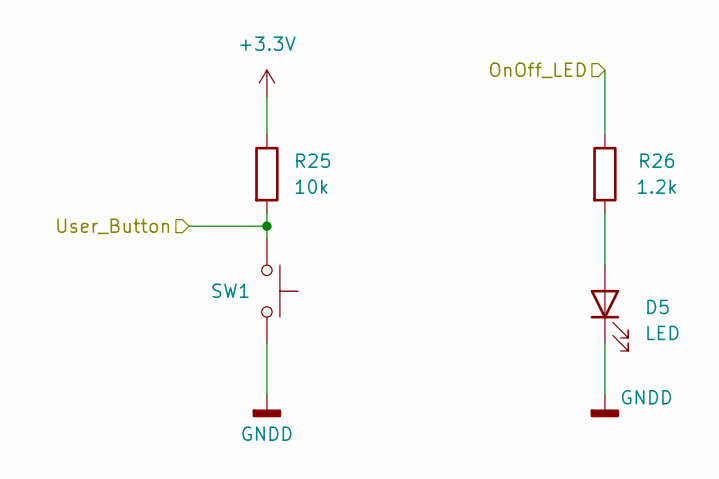
[picture p26: schematic Interfaz_Usuario.kicad_sch]

Parts:
D5: LED; LED_0603_1608Metric
R25: 10k; R_0603_1608Metric; LCSC PN C25804
R26: 1.2k; R_0603_1608Metric; LCSC PN C22765
SW1: SW_Push; SW_SPST_TL3305A

Connections:
+3.3V: R25.1; also elsewhere on the board
/CPU/OnOff_LED: R26.1; also elsewhere on the board
/CPU/User_Button: R25.2, SW1.1; also elsewhere on the board
GNDD: D5.1 (K), SW1.2; also elsewhere on the board
unnamed: D5.2 (A), R26.2

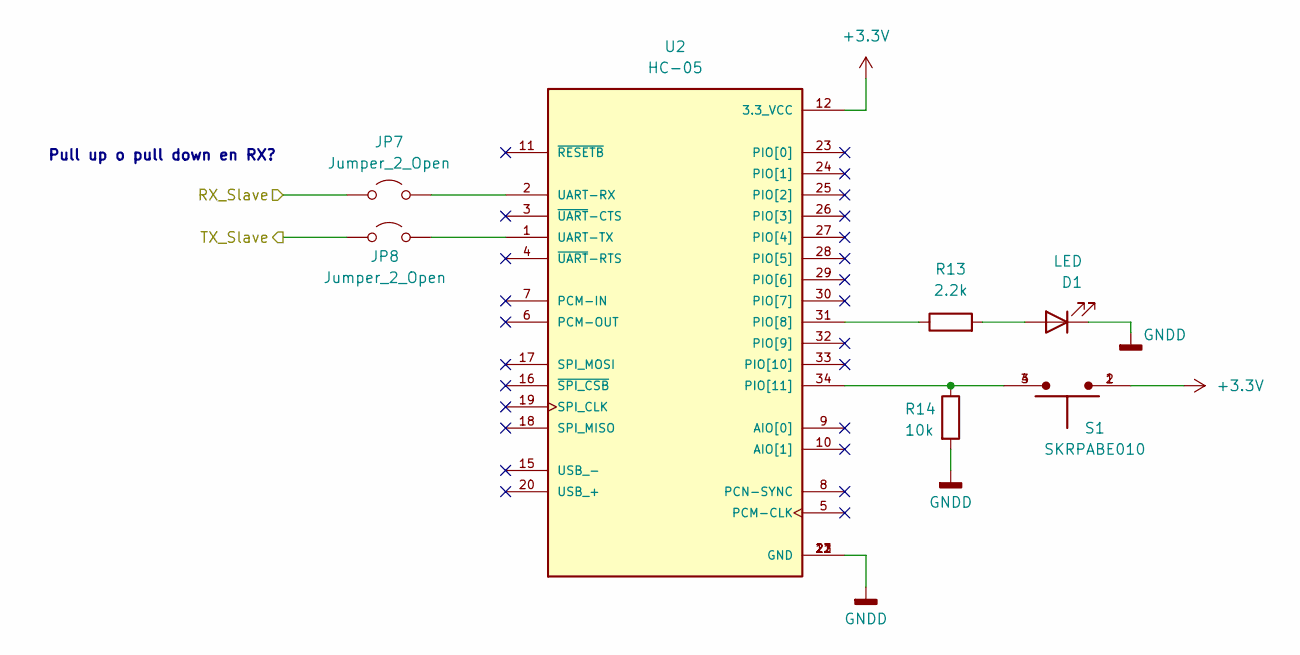
[picture p27: schematic Transmision.kicad_sch]

Parts:
D1: LED; LED_0603_1608Metric; LCSC PN C19171394
JP7, JP8: Jumper_2_Open; PinHeader_1x02_P2.54mm_Vertical
R13: 2.2k; R_0603_1608Metric
R14: 10k; R_0603_1608Metric; LCSC PN C25804
S1: SKRPABE010; SW_SKRPABE010; LCSC PN C115360
U2: HC-05; XCVR_HC-05; PARTREV v1.0

Connections:
+3.3V: S1.1, S1.2, U2.12 (3.3_VCC); also elsewhere on the board
/CPU/RX_Master: JP8.1 (A); also elsewhere on the board
/CPU/TX_Master: JP7.1 (A); also elsewhere on the board
GNDD: D1.1 (K), R14.2, U2.13 (GND), U2.21 (GND), U2.22 (GND); also elsewhere on the board
unnamed: D1.2 (A), R13.2
unnamed: JP7.2 (B), U2.2 (UART-RX)
unnamed: JP8.2 (B), U2.1 (UART-TX)
unnamed: R13.1, U2.31 (PIO[8])
unnamed: R14.1, S1.3, S1.4, U2.34 (PIO[11])

Notes on the sheet:
Pull up o pull down en RX?

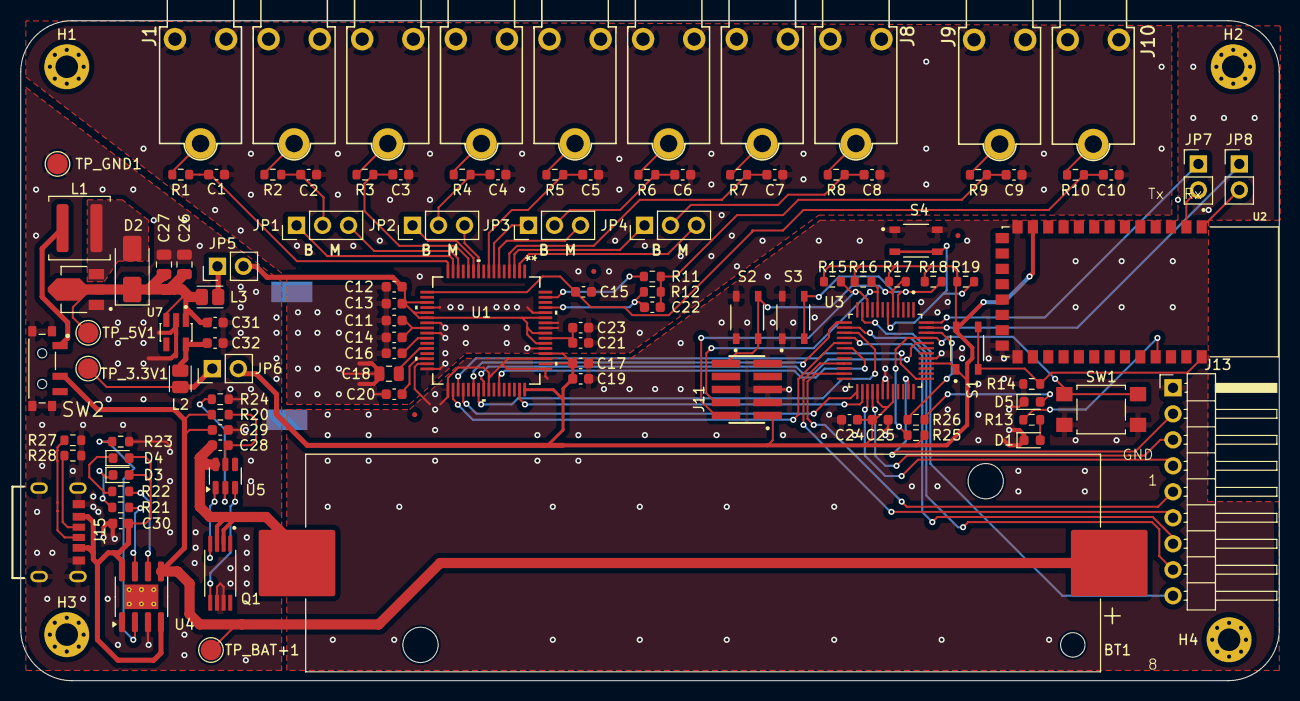
[picture p28: board Casco_EEG_Kicad.kicad_pcb from above]

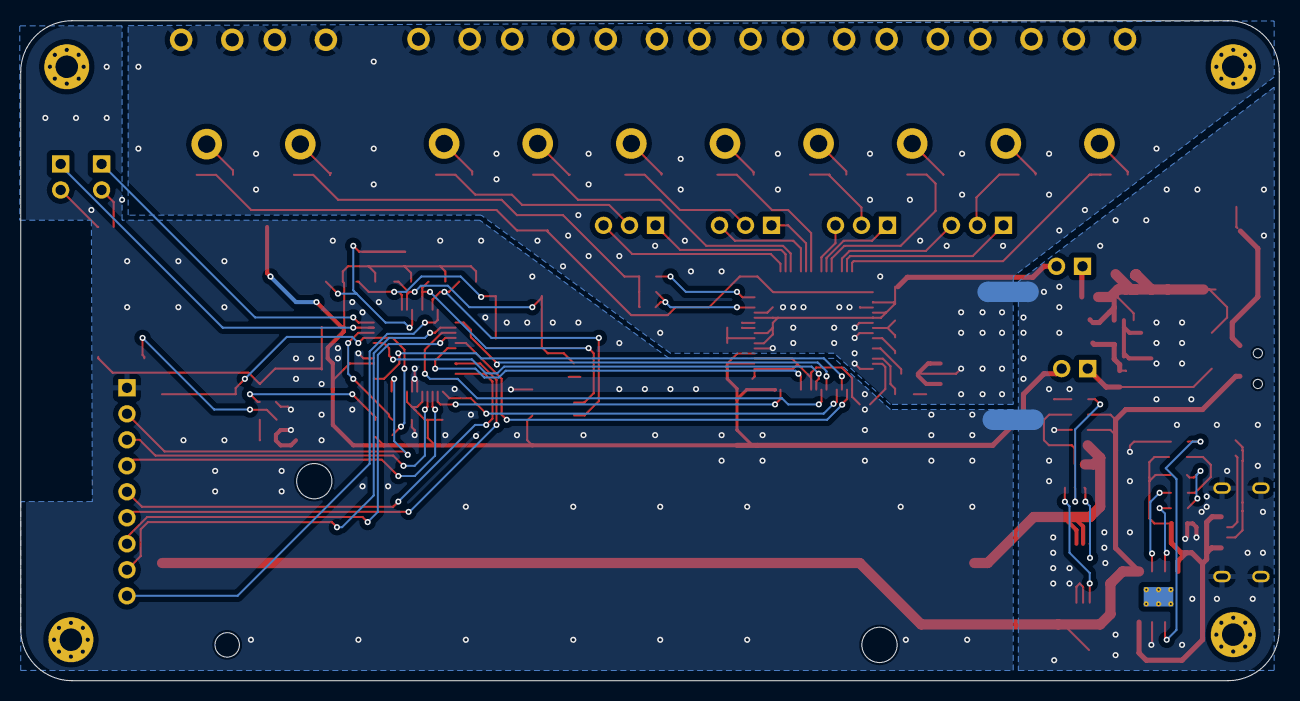
[picture p29: board Casco_EEG_Kicad.kicad_pcb from below]

Board: 2 copper layers, 123.0 x 64.5 mm, 117 parts (2 on the bottom side), 91 nets.
