lolobernardi/eeg-headset-project/firmware/proyecto_casco_EEG/board/hardware_init.c

/*
 * Copyright  2019 NXP
 * All rights reserved.
 *
 * SPDX-License-Identifier: BSD-3-Clause
 */

/*${header:start}*/
#include "pin_mux.h"
#include "board.h"
#include <stdbool.h>
/*${header:end}*/

/*${function:start}*/
void BOARD_InitHardware(void)
{
    /* Attach main clock to USART0 (debug console) */
    CLOCK_Select(kUART0_Clk_From_MainClk);

    BOARD_InitBootPins();
    BOARD_BootClockFRO30M();
    //BOARD_InitDebugConsole();

    /* Attach main clock to SPI0. */
    CLOCK_Select(kSPI0_Clk_From_MainClk);

    /* Turn on LED RED */
    LED_RED_INIT(LOGIC_LED_ON);
}
/*${function:end}*/
