lolobernardi/eeg-headset-project/(commit log)

2025-05-17 Agrego .gitignore para excluir archivos del IDE y binarios
2025-05-26 Importacion de ejemplos de SDK
2025-08-06 Actualizacion de los archivos del SDK
2025-08-11 Creo archivos para driver de ADS1299
2025-08-11 Implement ADS1299 driver and header
2025-08-13 Se agrega funcion de test para lectura y escritura de registros en ADS
2025-08-14 Resolucion de conflicto con stash
2025-08-14 Apliacion de funciones para ADS1299
2025-08-23 Lectura y escritura de registros del ADS funcionando
2025-09-03 Transmision basica funcional de datos al GUI de OpenBCI, agrego Bluetooth driver y openBCI communication
    [LPC845M301JBD48E.STEP, QFP50P900X900X160-48N.step]
2025-09-04 Nuevas funciones del Driver implementadas
2025-09-05 Implementacion de funciones para configurar registros de canales en ADS, sin probarfuncionamiento
2025-09-16 Agrego .gitignore para logs, IDE y binarios
2025-09-16 Implementacion de BIAS y configuracion CONFIG3, EEG funcionando
2025-09-25 Nuevo orden de carpetas y cambio de default settings
2025-09-25 Incluyo directorio con el proyecto de KiCad
    [Adquisicion.kicad_sch, Alimentacion.kicad_sch, CPU.kicad_sch, Casco_EEG_Kicad.kicad_pcb, Casco_EEG_Kicad.kicad_sch, FS8205A.step, FTSH-105-XX-X-DV.step, HC-05--3DModel-STEP-56544.STEP]
2025-10-02 Ignoro backups de Kicad, ligs, etc
2025-10-02 Primera implementacion de PCB, cambios varios
    [Adquisicion.kicad_sch, Alimentacion.kicad_sch, CPU.kicad_sch, Casco_EEG_Kicad.kicad_pcb, Casco_EEG_Kicad.kicad_sch, Interfaz_Usuario.kicad_sch, Jack_TouchProof_1.5mm.STEP, QFP50P900X900X160-48N.step]
2025-10-02 Ignoro backups de Kicad, logs, etc.
2025-10-09 Nuevos cambios al PCB, mejoro planos, regulo 3,3V desde 5V, etc
    [ADS1299IPAGR.STEP, AP2112K-3.3TRG1.step, Adquisicion.kicad_sch, Alimentacion.kicad_sch, CPU.kicad_sch, Casco_EEG_Kicad.kicad_pcb, HZ0805E601R-10--3DModel-STEP-510211.STEP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]
2025-10-09 Implemento pines I/O para trigger
    [Adquisicion.kicad_sch, Alimentacion.kicad_sch, CPU.kicad_sch, Casco_EEG_Kicad.kicad_pcb, Transmision.kicad_sch]
2025-10-22 Actualizacion del modelo, agrego mini slide switch, agrego jumpers para comunicacion con modulo BT
    [Alimentacion.kicad_sch, Casco_EEG_Kicad.kicad_pcb, PCM12SMTR.step, Transmision.kicad_sch, USB4125-GF-A_REVA2.step]
2025-10-28 Modifico pistas, cambios menores
    [Casco_EEG_Kicad.kicad_pcb]
2025-10-31 Agrego protecciones a las entradas analogicas, quito jumpers dealimentacion, agrego capacitores al HC05
    [Adquisicion.kicad_sch, Alimentacion.kicad_sch, Casco_EEG_Kicad.kicad_pcb, TPD2E001DRLR.step, TPD2E001DRLRG4.step, Transmision.kicad_sch, bom.csv, designators.csv]
2025-11-04 Cambio jumpers
    [Adquisicion.kicad_sch, Alimentacion.kicad_sch, Casco_EEG_Kicad.kicad_pcb, Transmision.kicad_sch, bom.csv, designators.csv, positions.csv, positions.csv.xlsx]
2025-11-11 Agrego GND para puente UART al modulo BT
    [Alimentacion.kicad_sch, Casco_EEG_Kicad.kicad_pcb, Transmision.kicad_sch]
2025-12-21 Agrego configuracion para poder realizar registros monopolares, desactivo entradas negativas para la conformacion de la señal de BIAS
2025-12-21 Ignoro carpeta de produccion de hardware
