lolobernardi/eeg-headset-project/(notices)

Notices in the files:
hardware/Casco_EEG_Kicad/3D_models/FTSH-105-XX-X-DV.step:
author */ ('License CC BY-ND 4.0'),
